Triver1/t-he/case/renders/exploded.png

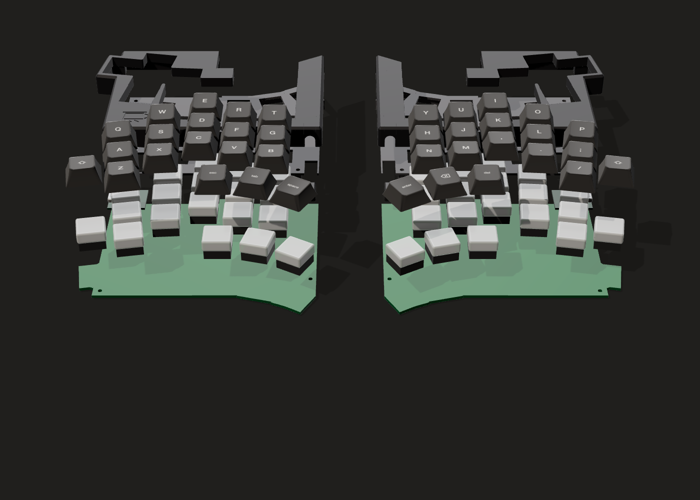
case/renders/exploded.png
