Triver1/t-he/case/renders/overview.png

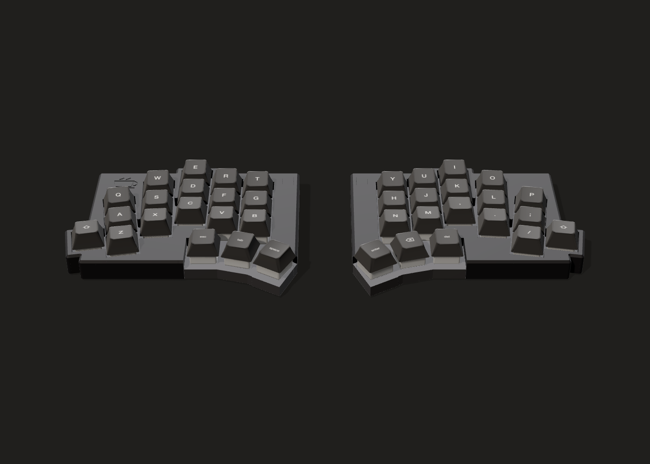
case/renders/overview.png
