Triver1/t-he/case/renders/thumb-cluster.png

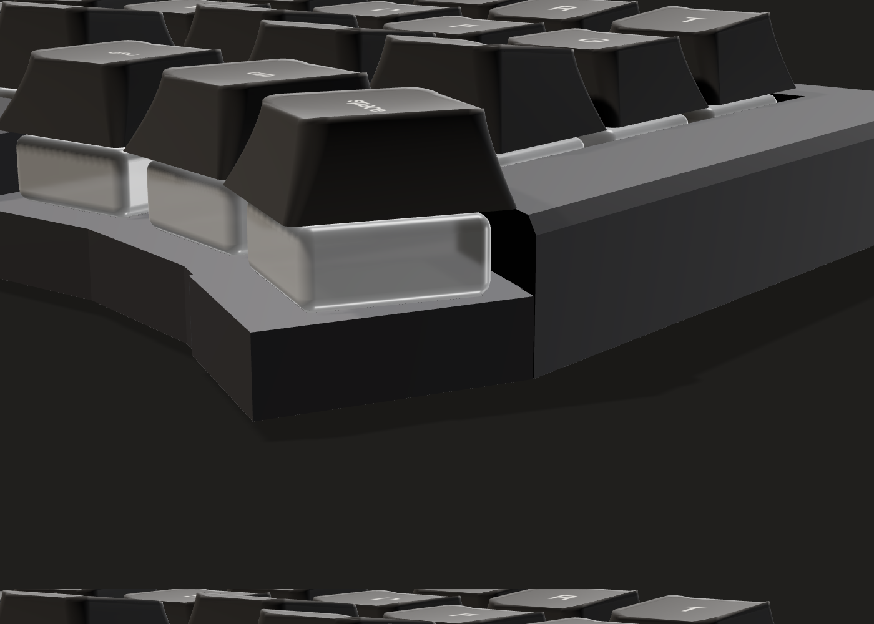
case/renders/thumb-cluster.png
