Triver1/t-he/pcb/art/cat.webp

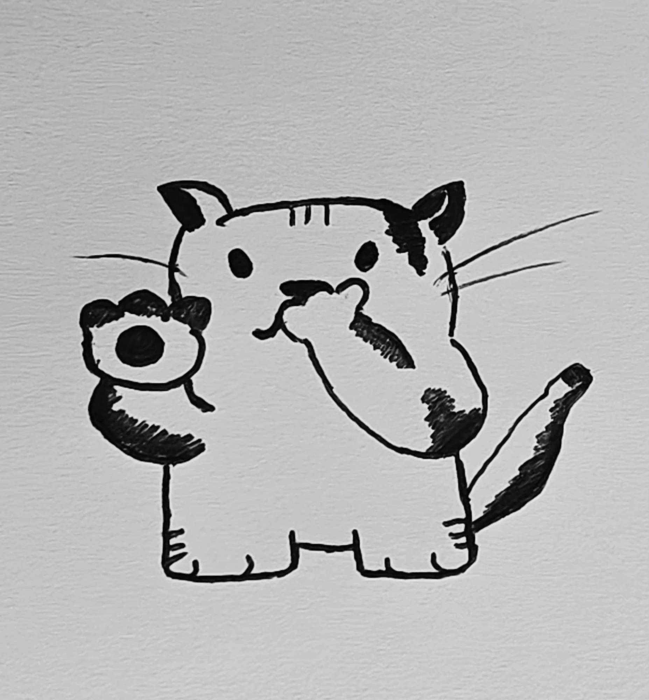
pcb/art/cat.webp
