Triver1/t-he/pcb/renders/pcb_left.png

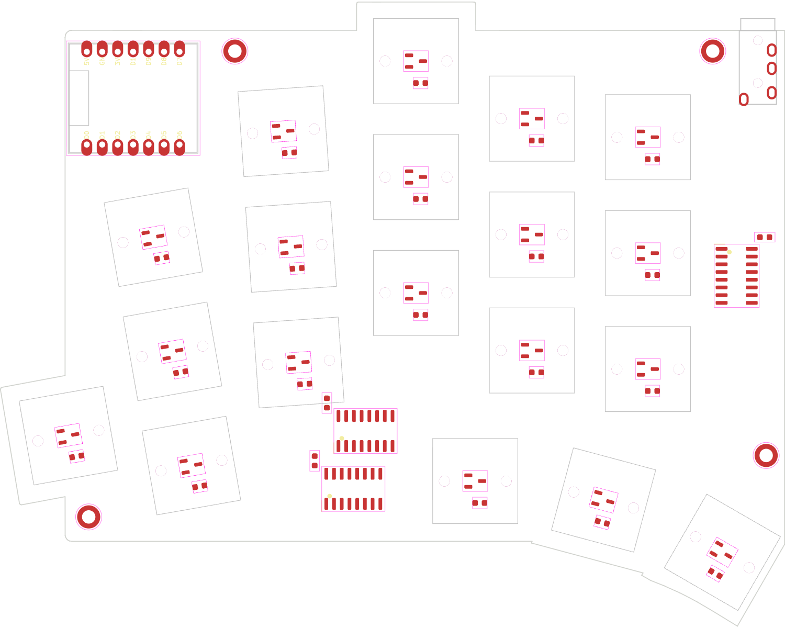
pcb/renders/pcb_left.png
