Triver1/t-he/pcb/renders/pcb_right.png

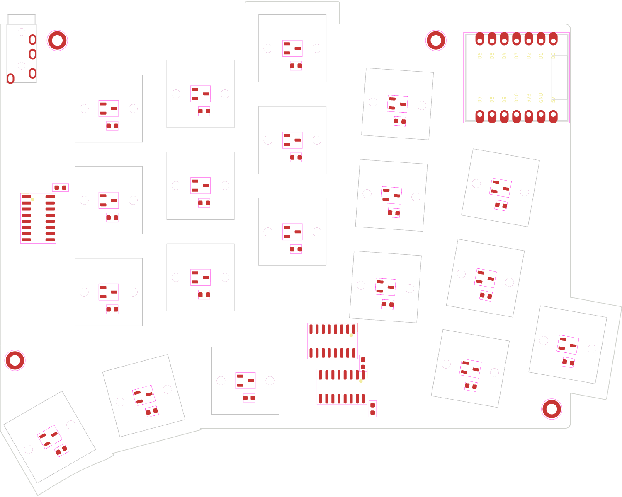
pcb/renders/pcb_right.png
