Triver1/t-he/production/lcsc_bom.csv

Quantity | LCSC Part Number | Manufacturer Part Number | Description
40 | C266128 | DRV5055A3QDBZR | Linear hall sensor, SOT-23 (38 needed, 2 spare)
6 | C9386 | 74HC4051D | 8-channel analog multiplexer, SOIC-16
50 | C1711 | CL21B104KBCNNNC | 100 nF 50 V X7R capacitor, 0805 (44 needed)
5 | C2884926 | PJ-320A | 3.5 mm TRRS jack, 4-pin through-hole (2 needed)
