Triver1/t-he/case/kicad/pcb_outline_right.dxf

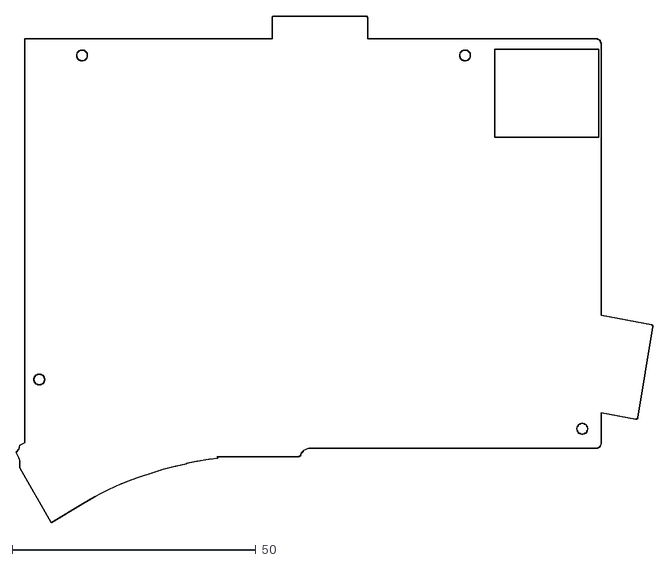
[picture p10: CAD file, 2026-09-22]
case/kicad/pcb_outline_right.dxf
130.6 x 103.9
