Triver1/t-he/case/stl/totemhe_pcbmock_left.stl

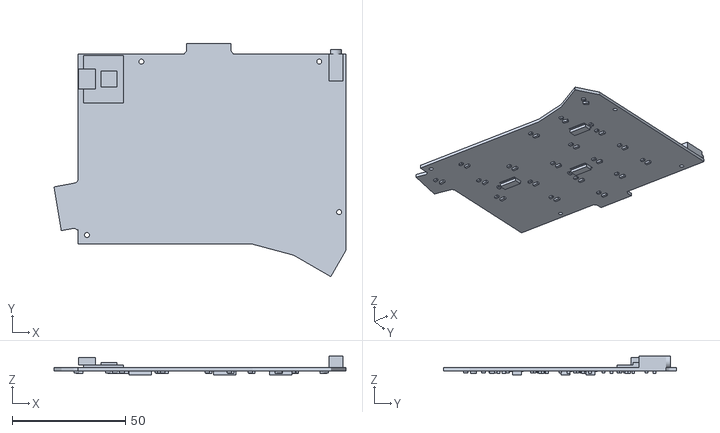
[picture p11: CAD file, 2026-10-24]
case/stl/totemhe_pcbmock_left.stl
128.9 x 103.0 x 8.25
