Triver1/t-he/pcb/out/left/outlines/board.dxf

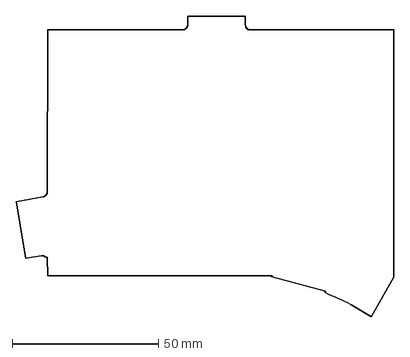
[picture p12: CAD file, 2026-09-22]
pcb/out/left/outlines/board.dxf
128.9 x 102.6 mm
