Triver1/t-he/pcb/out/left/points/demo.dxf

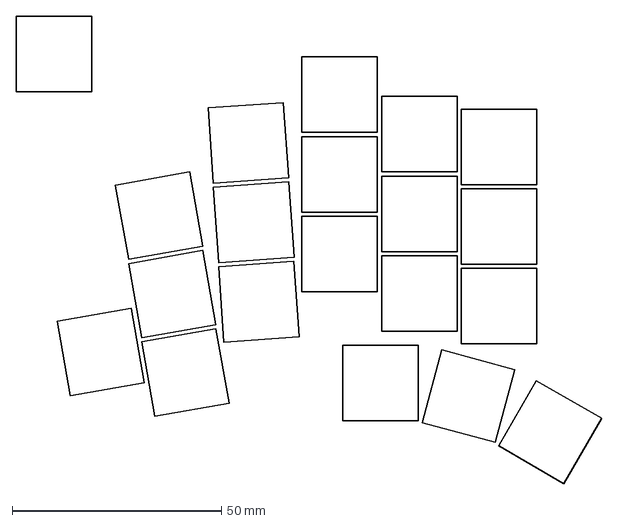
[picture p13: CAD file, 2026-09-22]
pcb/out/left/points/demo.dxf
140.0 x 111.8 mm
