Triver1/t-he/pcb/out/right/outlines/plate.dxf

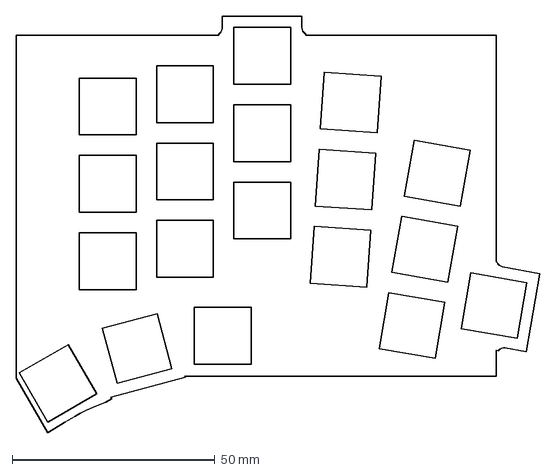
[picture p14: CAD file, 2026-09-22]
pcb/out/right/outlines/plate.dxf
128.9 x 102.6 mm
