Triver1/t-he/pcb/out/right/points/demo.dxf

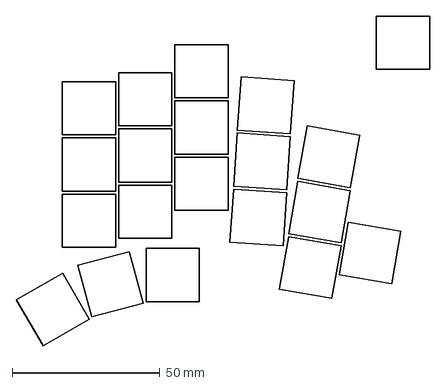
[picture p15: CAD file, 2026-09-22]
pcb/out/right/points/demo.dxf
140.0 x 111.8 mm
