Triver1/t-he/case/kicad/pcb_outline_left.dxf

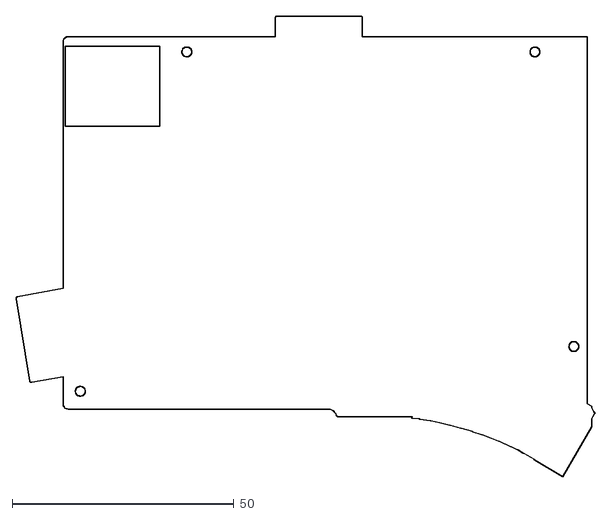
[picture p16: CAD file, 2026-09-22]
case/kicad/pcb_outline_left.dxf
130.6 x 103.9
