Triver1/t-he/pcb/out/left/outlines/plate.dxf

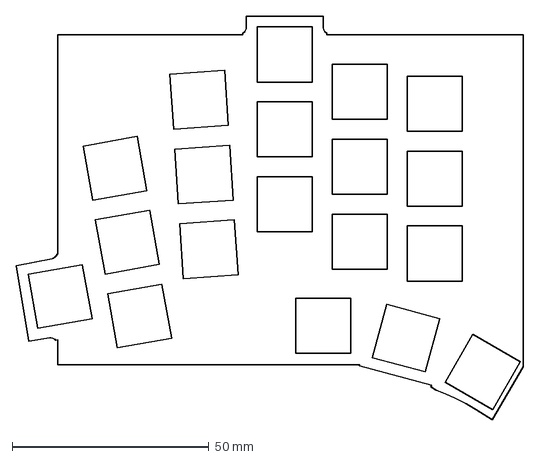
[picture p18: CAD file, 2026-09-22]
pcb/out/left/outlines/plate.dxf
128.9 x 102.6 mm
