Triver1/t-he/pcb/out/right/outlines/board.dxf

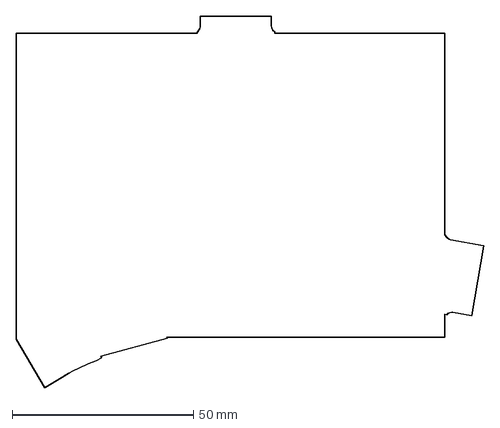
[picture p19: CAD file, 2026-09-22]
pcb/out/right/outlines/board.dxf
128.9 x 102.6 mm
