Triver1/t-he/case/stl/totemhe_foam_mold_base_right.stl

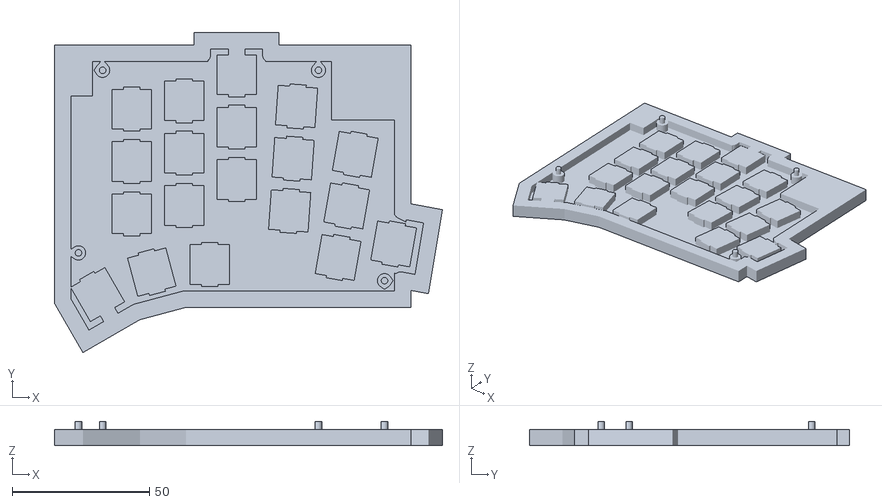
[picture p20: CAD file, 2026-10-24]
case/stl/totemhe_foam_mold_base_right.stl
141.2 x 116.5 x 8.79
