Triver1/t-he/case/stl/totemhe_plate_left.stl

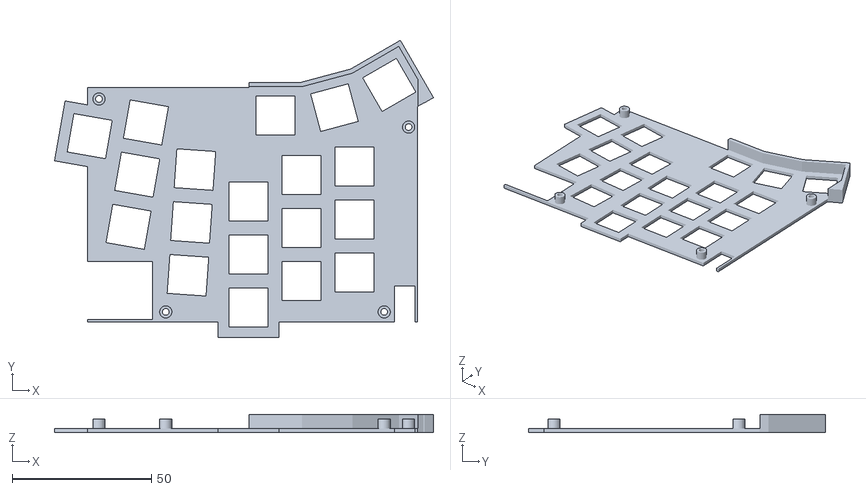
[picture p21: CAD file, 2026-10-04]
case/stl/totemhe_plate_left.stl
136.3 x 106.9 x 6.60
