Triver1/t-he/case/stl/totemhe_shell_right.stl

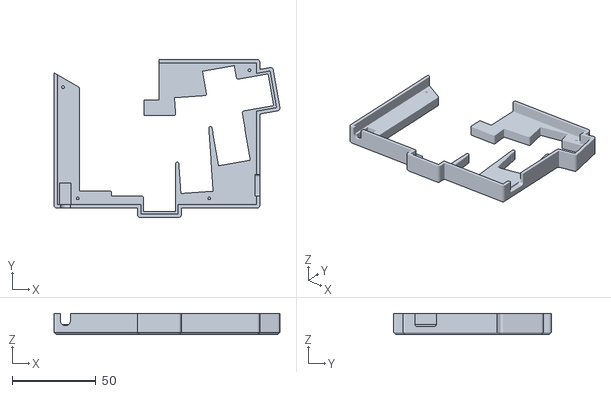
[picture p22: CAD file, 2026-10-04]
case/stl/totemhe_shell_right.stl
135.0 x 94.4 x 12.6
