Triver1/t-he/case/mock_parts.scad

// generated by gen_mock.py from totem_he.kicad_pcb: [name, x, y, rot]
mock_parts = [
  ["switch_he", 47.758, -40.236, 4.000],
  ["switch_he", 31.394, -76.180, 10.000],
  ["switch_he", 87.353, -57.268, 0.000],
  ["switch_he", 106.403, -41.266, 0.000],
  ["mux_4051", 75.300, -38.000, -90.000],
  ["switch_he", 68.303, -47.815, 0.000],
  ["switch_he", 118.878, -89.669, -30.000],
  ["mux_4051", 100.000, -70.500, 90.000],
  ["switch_he", 87.353, -19.168, 0.000],
  ["switch_he", 49.013, -59.240, 4.000],
  ["switch_he", 106.403, -22.216, 0.000],
  ["mux_4051", 38.000, -49.000, -90.000],
  ["switch_he", 106.403, -60.316, 0.000],
  ["switch_he", 11.178, -71.258, 10.000],
  ["switch_he", 25.145, -38.658, 10.000],
  ["xiao_rp2040", 21.811, -15.801, 90.000],
  ["switch_he", 99.177, -81.508, -15.000],
  ["switch_he", 68.303, -28.764, 0.000],
  ["switch_he", 46.503, -21.232, 4.000],
  ["switch_he", 28.270, -57.419, 10.000],
  ["switch_he", 78.034, -78.725, 0.000],
  ["switch_he", 87.353, -38.218, 0.000],
  ["switch_he", 68.303, -9.714, 0.000],
  ["trrs_pj320a", 124.470, -4.707, 0.000],
];
