Triver1/t-he/case/totem_geometry.scad

// TOTEM left half (GEIGEIGEIST/TOTEM rev 0.3), Choc 18 x 17 mm spacing scaled to MX 19.05 mm.
// Generated from totem_0_3.kicad_pcb and its Edge_Cuts gerber. y is up, origin at the board's top-left.
totem_pcb_edge = [[0.000,-63.652], [3.140,-82.457], [3.275,-82.602], [3.460,-82.636], [10.502,-81.320], [10.581,-81.338], [10.627,-81.431], [10.633,-87.629], [10.709,-87.946], [10.867,-88.222], [11.091,-88.439], [11.367,-88.579], [11.683,-88.630], [72.147,-88.630], [72.222,-88.663], [72.252,-88.732], [72.262,-90.062], [72.357,-90.229], [72.532,-90.312], [82.549,-90.315], [85.266,-90.356], [86.706,-90.422], [88.228,-90.536], [91.015,-90.868], [93.528,-91.296], [95.614,-91.733], [97.899,-92.283], [100.404,-92.959], [102.895,-93.701], [105.142,-94.438], [107.168,-95.173], [108.999,-95.904], [111.689,-97.117], [113.125,-97.841], [114.460,-98.564], [116.926,-100.007], [126.218,-105.684], [126.353,-105.728], [126.495,-105.702], [126.644,-105.562], [129.867,-99.651], [129.867,-85.269], [129.832,-85.186], [129.832,-74.948], [129.867,-74.864], [129.867,-20.565], [129.839,-20.490], [129.839,-5.776], [129.817,-5.547], [129.736,-5.292], [129.566,-5.024], [129.332,-4.820], [129.049,-4.693], [128.783,-4.657], [78.206,-4.656], [78.142,-4.624], [78.111,-4.545], [78.109,-0.301], [78.079,-0.186], [78.009,-0.089], [77.907,-0.021], [77.797,0.000], [58.780,-0.007], [58.612,-0.111], [58.533,-0.301], [58.532,-4.545], [58.501,-4.624], [58.437,-4.656], [11.683,-4.657], [11.472,-4.679], [11.269,-4.746], [11.008,-4.914], [10.805,-5.153], [10.673,-5.446], [10.627,-5.776], [10.625,-61.313], [10.539,-61.401], [0.245,-63.325], [0.067,-63.443]];
// [x, y, rotation, is_thumb]
totem_keys = [
  [25.145, -38.658, 10.0, 0],
  [46.503, -21.232, 4.0, 0],
  [68.303, -9.714, 0.0, 0],
  [87.353, -19.168, 0.0, 0],
  [106.403, -22.216, 0.0, 0],
  [28.270, -57.419, 10.0, 0],
  [47.758, -40.236, 4.0, 0],
  [68.303, -28.764, 0.0, 0],
  [87.353, -38.218, 0.0, 0],
  [106.403, -41.266, 0.0, 0],
  [31.394, -76.180, 10.0, 0],
  [49.013, -59.240, 4.0, 0],
  [68.303, -47.815, 0.0, 0],
  [87.353, -57.268, 0.0, 0],
  [106.403, -60.316, 0.0, 0],
  [11.178, -71.258, 10.0, 0],
  // thumbs: 4 mm further inward and 1.75 mm further up than TOTEM: the outer thumb clears the straight inner side, and thumb 1's front edge lines up with the main body's bottom edge.
  // Thumbs 2 and 3 sit on an 81.69 mm arc centred straight below thumb 1, 15 degrees apart, so the plate's front corners fall mid-gap
  [78.034, -78.725, 0.0, 1],
  [99.177, -81.508, -15.0, 1],
  [118.878, -89.669, -30.0, 1]];
totem_holes = [[125.845, -74.520], [14.509, -84.621], [38.533, -8.069], [117.061, -8.069]];
totem_xiao = [21.811, -15.801];   // centre; USB-C faces the outer edge
totem_trrs = [124.470, -4.707];   // MJ-4PP-9, mouth faces the back edge
totem_side_x = 129.870;   // the straight inner side of the board edge
