Triver1/t-he/(list of files, cad)

Other CAD files:
case/stl/totemhe_foam_mold_lid_left.stl
case/stl/totemhe_pcbmock_right.stl
case/stl/totemhe_foam_mold_base_left.stl
case/stl/totemhe_shell_left.stl
case/stl/totemhe_plate_right.stl
case/mock_parts_right.scad
