Triver1/t-he/pcb/totem_he.kicad_pcb

## KiCad design pcb/totem_he.kicad_pcb (2026-10-24)

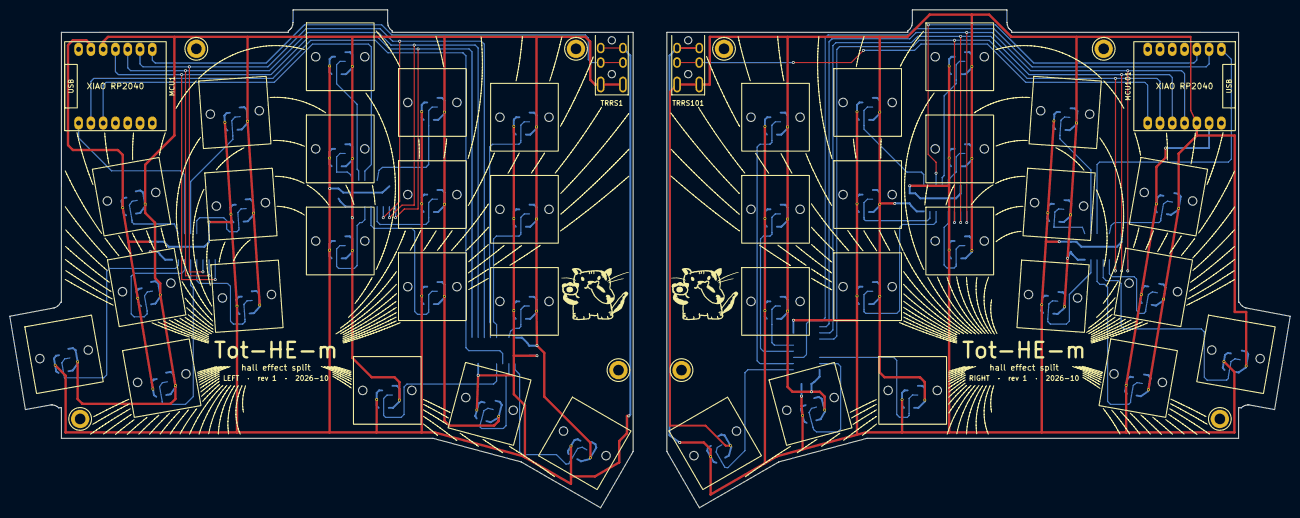
[picture p23: board totem_he.kicad_pcb from above]

Board: 2 copper layers, 264.8 x 103.0 mm, 56 parts (0 on the bottom side), 56 nets.

Parts:
H1, H2, H3, H4, H101, H102, H103, H104: mounting_hole_plated
IC1, IC2, IC3, IC101, IC102, IC103: mux_4051
MCU1, MCU101: xiao_rp2040
S1, S2, S3, S4, S5, S6, S7, S8, S9, S10, S11, S12, S13, S14, S15, S16, S17, S18, S19, S101, S102, S103, S104, S105, S106, S107, S108, S109, S110, S111, S112, S113, S114, S115, S116, S117, S118, S119: switch_he
TRRS1, TRRS101: trrs_pj320a

Connections:
L/ADC_A: IC1.3, MCU1.1
L/ADC_B: IC2.3, MCU1.3
L/ADC_C: IC3.3, MCU1.2
L/DATA: MCU1.8, TRRS1.3
L/GND: IC1.6, IC1.7, IC1.8, IC1.C2, IC2.6, IC2.7, IC2.8, IC2.C2, IC3.6, IC3.7, IC3.8, IC3.C2, MCU1.13, S1.3, S1.C2, S2.3, S2.C2, S3.3, S3.C2, S4.3, S4.C2, S5.3, S5.C2, S6.3, S6.C2, S7.3, S7.C2, S8.3, S8.C2, S9.3, S9.C2, S10.3, S10.C2, S11.3, S11.C2, S12.3, S12.C2, S13.3, S13.C2, S14.3, S14.C2, S15.3, S15.C2, S16.3, S16.C2, S17.3, S17.C2, S18.3, S18.C2, S19.3, S19.C2, TRRS1.2
L/K_INDEX_BOTTOM: IC2.13, S14.2
L/K_INDEX_HOME: IC2.12, S9.2
L/K_INDEX_TOP: IC2.5, S4.2
L/K_INNER_BOTTOM: IC3.15, S15.2
L/K_INNER_HOME: IC3.13, S10.2
L/K_INNER_TOP: IC3.12, S5.2
L/K_MIDDLE_BOTTOM: IC2.14, S13.2
L/K_MIDDLE_HOME: IC2.1, S8.2
L/K_MIDDLE_TOP: IC2.2, S3.2
L/K_OUTER: IC1.15, S16.2
L/K_PINKY_BOTTOM: IC1.13, S11.2
L/K_PINKY_HOME: IC1.14, S6.2
L/K_PINKY_TOP: IC1.2, S1.2
L/K_RING_BOTTOM: IC1.12, S12.2
L/K_RING_HOME: IC1.5, S7.2
L/K_RING_TOP: IC1.4, S2.2
L/K_THUMB1: IC3.4, S17.2
L/K_THUMB2: IC3.2, S18.2
L/K_THUMB3: IC3.1, S19.2
L/SEL0: IC1.11, IC2.11, IC3.11, MCU1.9
L/SEL1: IC1.10, IC2.10, IC3.10, MCU1.10
L/SEL2: IC1.9, IC2.9, IC3.9, MCU1.11
L/VCC: IC1.16, IC1.C1, IC2.16, IC2.C1, IC3.16, IC3.C1, MCU1.12, S1.1, S1.C1, S2.1, S2.C1, S3.1, S3.C1, S4.1, S4.C1, S5.1, S5.C1, S6.1, S6.C1, S7.1, S7.C1, S8.1, S8.C1, S9.1, S9.C1, S10.1, S10.C1, S11.1, S11.C1, S12.1, S12.C1, S13.1, S13.C1, S14.1, S14.C1, S15.1, S15.C1, S16.1, S16.C1, S17.1, S17.C1, S18.1, S18.C1, S19.1, S19.C1, TRRS1.4
R/ADC_A: IC101.3, MCU101.1
R/ADC_B: IC102.3, MCU101.3
R/ADC_C: IC103.3, MCU101.2
R/DATA: MCU101.8, TRRS101.3
R/GND: IC101.6, IC101.7, IC101.8, IC101.C2, IC102.6, IC102.7, IC102.8, IC102.C2, IC103.6, IC103.7, IC103.8, IC103.C2, MCU101.13, S101.3, S101.C2, S102.3, S102.C2, S103.3, S103.C2, S104.3, S104.C2, S105.3, S105.C2, S106.3, S106.C2, S107.3, S107.C2, S108.3, S108.C2, S109.3, S109.C2, S110.3, S110.C2, S111.3, S111.C2, S112.3, S112.C2, S113.3, S113.C2, S114.3, S114.C2, S115.3, S115.C2, S116.3, S116.C2, S117.3, S117.C2, S118.3, S118.C2, S119.3, S119.C2, TRRS101.2
R/K_INDEX_BOTTOM: IC102.14, S114.2
R/K_INDEX_HOME: IC102.15, S109.2
R/K_INDEX_TOP: IC102.1, S104.2
R/K_INNER_BOTTOM: IC103.5, S115.2
R/K_INNER_HOME: IC103.4, S110.2
R/K_INNER_TOP: IC103.2, S105.2
R/K_MIDDLE_BOTTOM: IC102.12, S113.2
R/K_MIDDLE_HOME: IC102.5, S108.2
R/K_MIDDLE_TOP: IC102.4, S103.2
R/K_OUTER: IC101.13, S116.2
R/K_PINKY_BOTTOM: IC101.14, S111.2
R/K_PINKY_HOME: IC101.12, S106.2
R/K_PINKY_TOP: IC101.5, S101.2
R/K_RING_BOTTOM: IC101.15, S112.2
R/K_RING_HOME: IC101.1, S107.2
R/K_RING_TOP: IC101.2, S102.2
R/K_THUMB1: IC103.14, S117.2
R/K_THUMB2: IC103.15, S118.2
R/K_THUMB3: IC103.1, S119.2
R/SEL0: IC101.11, IC102.11, IC103.11, MCU101.9
R/SEL1: IC101.10, IC102.10, IC103.10, MCU101.10
R/SEL2: IC101.9, IC102.9, IC103.9, MCU101.11
R/VCC: IC101.16, IC101.C1, IC102.16, IC102.C1, IC103.16, IC103.C1, MCU101.12, S101.1, S101.C1, S102.1, S102.C1, S103.1, S103.C1, S104.1, S104.C1, S105.1, S105.C1, S106.1, S106.C1, S107.1, S107.C1, S108.1, S108.C1, S109.1, S109.C1, S110.1, S110.C1, S111.1, S111.C1, S112.1, S112.C1, S113.1, S113.C1, S114.1, S114.C1, S115.1, S115.C1, S116.1, S116.C1, S117.1, S117.C1, S118.1, S118.C1, S119.1, S119.C1, TRRS101.4
