Triver1/t-he/pcb/out/left/pcbs/totem_he_left.kicad_pcb

## KiCad design pcb/out/left/pcbs/totem_he_left.kicad_pcb (2026-09-22)

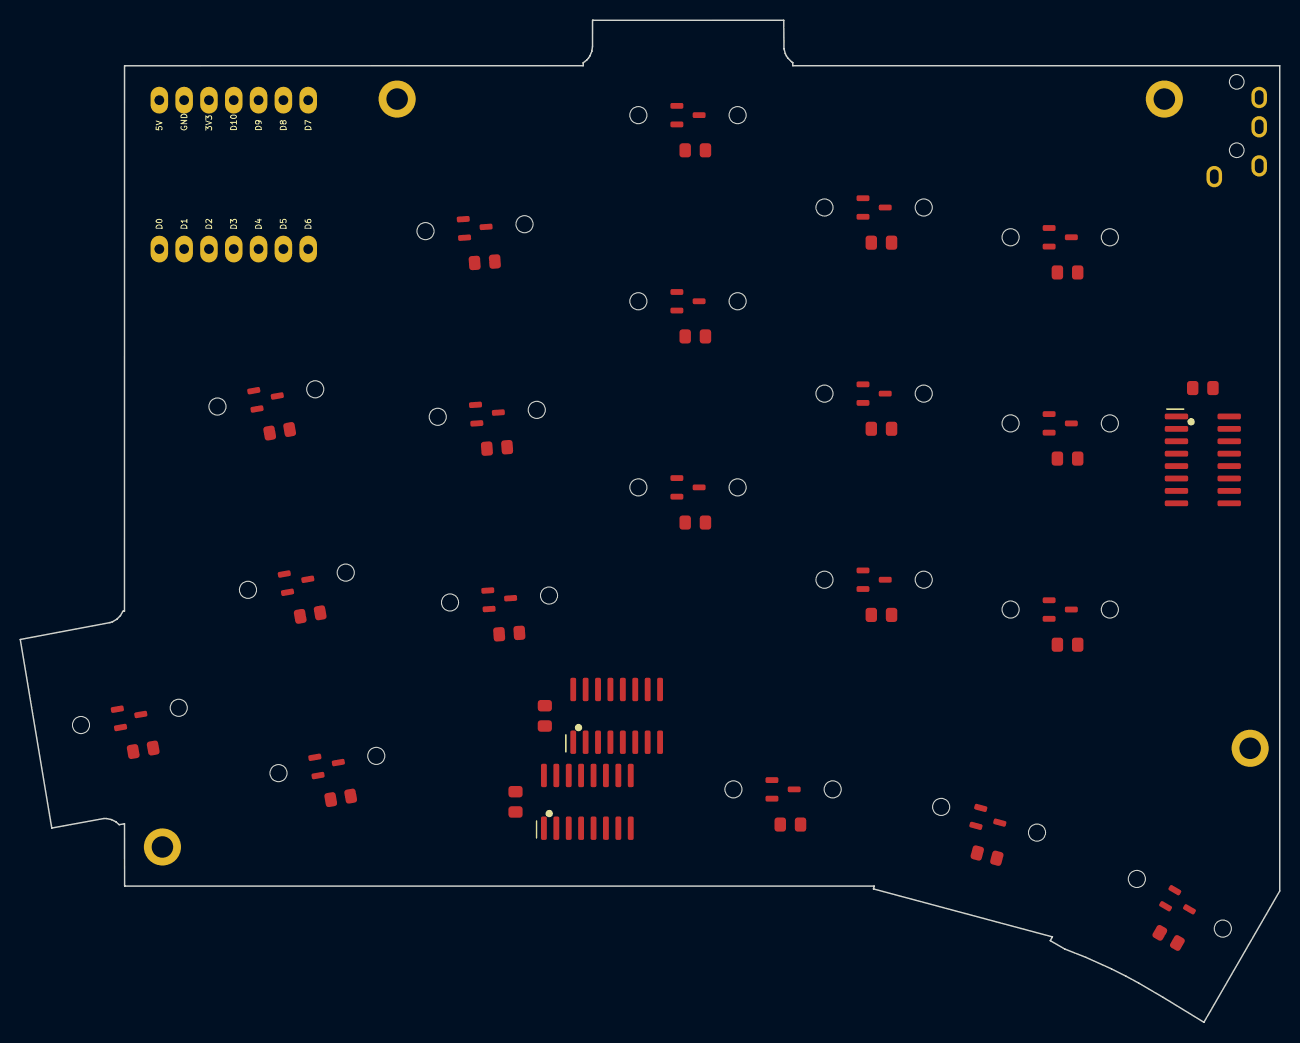
[picture p24: board totem_he_left.kicad_pcb from above]

Board: 2 copper layers, 128.9 x 102.6 mm, 28 parts (0 on the bottom side), 30 nets, no tracks yet.

Parts:
H1, H2, H3, H4: mounting_hole_plated
IC1, IC2, IC3: mux_4051
MCU1: xiao_rp2040
S1, S2, S3, S4, S5, S6, S7, S8, S9, S10, S11, S12, S13, S14, S15, S16, S17, S18, S19: switch_he
TRRS1: trrs_pj320a

Connections:
ADC_A: IC1.3, MCU1.1
ADC_B: IC2.3, MCU1.2
ADC_C: IC3.3, MCU1.3
GND: IC1.6, IC1.7, IC1.8, IC1.C2, IC2.6, IC2.7, IC2.8, IC2.C2, IC3.6, IC3.7, IC3.8, IC3.C2, MCU1.13, S1.2, S1.C2, S2.2, S2.C2, S3.2, S3.C2, S4.2, S4.C2, S5.2, S5.C2, S6.2, S6.C2, S7.2, S7.C2, S8.2, S8.C2, S9.2, S9.C2, S10.2, S10.C2, S11.2, S11.C2, S12.2, S12.C2, S13.2, S13.C2, S14.2, S14.C2, S15.2, S15.C2, S16.2, S16.C2, S17.2, S17.C2, S18.2, S18.C2, S19.2, S19.C2, TRRS1.2
K_INDEX_BOTTOM: IC2.12, S10.3
K_INDEX_HOME: IC2.1, S11.3
K_INDEX_TOP: IC2.5, S12.3
K_INNER_BOTTOM: IC3.13, S13.3
K_INNER_HOME: IC3.14, S14.3
K_INNER_TOP: IC3.15, S15.3
K_MIDDLE_BOTTOM: IC2.13, S7.3
K_MIDDLE_HOME: IC2.14, S8.3
K_MIDDLE_TOP: IC2.15, S9.3
K_OUTER: IC1.12, S16.3
K_PINKY_BOTTOM: IC1.13, S1.3
K_PINKY_HOME: IC1.14, S2.3
K_PINKY_TOP: IC1.15, S3.3
K_RING_BOTTOM: IC1.1, S4.3
K_RING_HOME: IC1.5, S5.3
K_RING_TOP: IC1.2, S6.3
K_THUMB1: IC2.2, S17.3
K_THUMB2: IC2.4, S18.3
K_THUMB3: IC3.12, S19.3
RX: MCU1.8, TRRS1.3
SEL0: IC1.11, IC2.11, IC3.11, MCU1.5
SEL1: IC1.10, IC2.10, IC3.10, MCU1.6
SEL2: IC1.9, IC2.9, IC3.9, MCU1.9
TX: MCU1.7, TRRS1.5
VCC: IC1.16, IC1.C1, IC2.16, IC2.C1, IC3.16, IC3.C1, MCU1.12, S1.1, S1.C1, S2.1, S2.C1, S3.1, S3.C1, S4.1, S4.C1, S5.1, S5.C1, S6.1, S6.C1, S7.1, S7.C1, S8.1, S8.C1, S9.1, S9.C1, S10.1, S10.C1, S11.1, S11.C1, S12.1, S12.C1, S13.1, S13.C1, S14.1, S14.C1, S15.1, S15.C1, S16.1, S16.C1, S17.1, S17.C1, S18.1, S18.C1, S19.1, S19.C1, TRRS1.4
Y7: IC1.4, IC3.4
