Triver1/t-he/pcb/out/left/config.yaml

meta:
  engine: 4.1.0
  name: totem_he_left
units:
  u: 19.05
points:
  zones:
    origin:
      anchor: {shift: [0, 0]}
      columns: {o: }
      rows: {r: {tags: [helper]}}
    pinky:
      anchor: {shift: [31.394, -76.180], rotate: 10.000}
      key: {padding: u, tags: [alpha]}
      columns: {c: }
      rows:
        bottom: {name: pinky_bottom, out_net: K_PINKY_BOTTOM}
        home: {name: pinky_home, out_net: K_PINKY_HOME, adjust: {shift: [0.181, -0.032]}}
        top: {name: pinky_top, out_net: K_PINKY_TOP, adjust: {shift: [0.362, -0.063]}}
    ring:
      anchor: {shift: [49.013, -59.240], rotate: 4.000}
      key: {padding: u, tags: [alpha]}
      columns: {c: }
      rows:
        bottom: {name: ring_bottom, out_net: K_RING_BOTTOM}
        home: {name: ring_home, out_net: K_RING_HOME, adjust: {shift: [0.074, -0.005]}}
        top: {name: ring_top, out_net: K_RING_TOP, adjust: {shift: [0.147, -0.009]}}
    middle:
      anchor: {shift: [68.303, -47.815], rotate: 0.000}
      key: {padding: u, tags: [alpha]}
      columns: {c: }
      rows:
        bottom: {name: middle_bottom, out_net: K_MIDDLE_BOTTOM}
        home: {name: middle_home, out_net: K_MIDDLE_HOME, adjust: {shift: [0.000, 0.001]}}
        top: {name: middle_top, out_net: K_MIDDLE_TOP, adjust: {shift: [0.000, 0.001]}}
    index:
      anchor: {shift: [87.353, -57.268], rotate: 0.000}
      key: {padding: u, tags: [alpha]}
      columns: {c: }
      rows:
        bottom: {name: index_bottom, out_net: K_INDEX_BOTTOM}
        home: {name: index_home, out_net: K_INDEX_HOME}
        top: {name: index_top, out_net: K_INDEX_TOP}
    inner:
      anchor: {shift: [106.403, -60.316], rotate: 0.000}
      key: {padding: u, tags: [alpha]}
      columns: {c: }
      rows:
        bottom: {name: inner_bottom, out_net: K_INNER_BOTTOM}
        home: {name: inner_home, out_net: K_INNER_HOME}
        top: {name: inner_top, out_net: K_INNER_TOP}
    outer:
      anchor: {shift: [11.178, -71.258], rotate: 10.000}
      key: {padding: u, tags: [alpha]}
      columns: {c: }
      rows:
        k: {name: outer, out_net: K_OUTER}
    thumb1:
      anchor: {shift: [78.034, -78.725], rotate: 0.000}
      key: {padding: u, tags: [thumb]}
      columns: {c: }
      rows:
        k: {name: thumb1, out_net: K_THUMB1}
    thumb2:
      anchor: {shift: [99.120, -81.835], rotate: -15.000}
      key: {padding: u, tags: [thumb]}
      columns: {c: }
      rows:
        k: {name: thumb2, out_net: K_THUMB2}
    thumb3:
      anchor: {shift: [118.647, -90.435], rotate: -30.000}
      key: {padding: u, tags: [thumb]}
      columns: {c: }
      rows:
        k: {name: thumb3, out_net: K_THUMB3}
outlines:
  board:
    - what: polygon
      operation: add
      points:
        - {ref: origin_o_r, shift: [78.892, -4.243]}
        - {ref: origin_o_r, shift: [78.523, -3.874]}
        - {ref: origin_o_r, shift: [78.378, -3.656]}
        - {ref: origin_o_r, shift: [78.262, -3.421]}
        - {ref: origin_o_r, shift: [78.127, -2.917]}
        - {ref: origin_o_r, shift: [78.105, -0.004]}
        - {ref: origin_o_r, shift: [58.599, -0.007]}
        - {ref: origin_o_r, shift: [58.537, -0.011]}
        - {ref: origin_o_r, shift: [58.533, -0.072]}
        - {ref: origin_o_r, shift: [58.532, -2.657]}
        - {ref: origin_o_r, shift: [58.464, -3.174]}
        - {ref: origin_o_r, shift: [58.264, -3.656]}
        - {ref: origin_o_r, shift: [58.119, -3.874]}
        - {ref: origin_o_r, shift: [57.946, -4.071]}
        - {ref: origin_o_r, shift: [57.578, -4.358]}
        - {ref: origin_o_r, shift: [57.578, -4.656]}
        - {ref: origin_o_r, shift: [10.631, -4.661]}
        - {ref: origin_o_r, shift: [10.625, -60.465]}
        - {ref: origin_o_r, shift: [10.472, -60.492]}
        - {ref: origin_o_r, shift: [10.212, -60.942]}
        - {ref: origin_o_r, shift: [9.843, -61.311]}
        - {ref: origin_o_r, shift: [9.390, -61.572]}
        - {ref: origin_o_r, shift: [9.143, -61.656]}
        - {ref: origin_o_r, shift: [-0.041, -63.383]}
        - {ref: origin_o_r, shift: [3.182, -82.683]}
        - {ref: origin_o_r, shift: [8.522, -81.707]}
        - {ref: origin_o_r, shift: [8.783, -81.710]}
        - {ref: origin_o_r, shift: [9.294, -81.818]}
        - {ref: origin_o_r, shift: [9.760, -82.055]}
        - {ref: origin_o_r, shift: [10.087, -82.341]}
        - {ref: origin_o_r, shift: [10.628, -82.245]}
        - {ref: origin_o_r, shift: [10.638, -88.626]}
        - {ref: origin_o_r, shift: [87.362, -88.625]}
        - {ref: origin_o_r, shift: [87.285, -88.913]}
        - {ref: origin_o_r, shift: [105.606, -93.822]}
        - {ref: origin_o_r, shift: [105.383, -94.209]}
        - {ref: origin_o_r, shift: [106.860, -95.061]}
        - {ref: origin_o_r, shift: [109.039, -95.922]}
        - {ref: origin_o_r, shift: [111.649, -97.099]}
        - {ref: origin_o_r, shift: [113.151, -97.855]}
        - {ref: origin_o_r, shift: [114.431, -98.548]}
        - {ref: origin_o_r, shift: [116.943, -100.017]}
        - {ref: origin_o_r, shift: [121.112, -102.565]}
        - {ref: origin_o_r, shift: [128.870, -89.128]}
        - {ref: origin_o_r, shift: [128.870, -4.657]}
        - {ref: origin_o_r, shift: [79.028, -4.656]}
        - {ref: origin_o_r, shift: [79.028, -4.333]}
  plate:
    - what: outline
      name: board
    - what: rectangle
      operation: subtract
      where: [alpha, thumb]
      size: 14
pcbs:
  totem_he_left:
    template: kicad8
    outlines:
      main: {outline: board}
    footprints:
      - what: switch_he
        where: [alpha, thumb]
        params: {VCC: VCC, GND: GND, OUT: "{{out_net}}"}
      - what: mux_4051
        where: {ref: origin_o_r, shift: [58.000, -80.000], rotate: 90.000}
        params: {VCC: VCC, GND: GND, Z: ADC_A, S0: SEL0, S1: SEL1, S2: SEL2, Y0: K_PINKY_BOTTOM, Y1: K_PINKY_HOME, Y2: K_PINKY_TOP, Y3: K_OUTER, Y4: K_RING_BOTTOM, Y5: K_RING_HOME, Y6: K_RING_TOP}
      - what: mux_4051
        where: {ref: origin_o_r, shift: [61.000, -71.200], rotate: 90.000}
        params: {VCC: VCC, GND: GND, Z: ADC_B, S0: SEL0, S1: SEL1, S2: SEL2, Y0: K_MIDDLE_BOTTOM, Y1: K_MIDDLE_HOME, Y2: K_MIDDLE_TOP, Y3: K_INDEX_BOTTOM, Y4: K_INDEX_HOME, Y5: K_INDEX_TOP, Y6: K_THUMB1, Y7: K_THUMB2}
      - what: mux_4051
        where: {ref: origin_o_r, shift: [121.000, -45.000], rotate: 0.000}
        params: {VCC: VCC, GND: GND, Z: ADC_C, S0: SEL0, S1: SEL1, S2: SEL2, Y0: K_INNER_BOTTOM, Y1: K_INNER_HOME, Y2: K_INNER_TOP, Y3: K_THUMB3}
      - what: xiao_rp2040
        where: {ref: origin_o_r, shift: [21.811, -15.801], rotate: 90.000}
        params: {D0: ADC_A, D1: ADC_B, D2: ADC_C, D4: SEL0, D5: SEL1, D8: SEL2, D6: TX, D7: RX, V3: VCC, GND: GND}
      - what: ceoloide/trrs_pj320a
        where: {ref: origin_o_r, shift: [124.470, -4.707]}
        params: {TP: VCC, R1: TX, R2: RX, SL: GND}
      - what: ceoloide/mounting_hole_plated
        where: {ref: origin_o_r, shift: [125.845, -74.520]}
        params: {drill: 2.2}
      - what: ceoloide/mounting_hole_plated
        where: {ref: origin_o_r, shift: [14.509, -84.621]}
        params: {drill: 2.2}
      - what: ceoloide/mounting_hole_plated
        where: {ref: origin_o_r, shift: [38.533, -8.069]}
        params: {drill: 2.2}
      - what: ceoloide/mounting_hole_plated
        where: {ref: origin_o_r, shift: [117.061, -8.069]}
        params: {drill: 2.2}
