Triver1/t-he/firmware/qmk/tot_he_m/he_map.h

// SPDX-License-Identifier: GPL-2.0-or-later
// Pin and channel map of the routed board (pcb/totem_he.kicad_pcb): which XIAO pins drive the muxes, and which mux
// channel carries which key on each half.
#pragma once

// mux commons, one per matrix row: D0 (mux IC1), D1 (mux IC3), D2 (mux IC2)
#define HE_ROW_PINS { GP26, GP27, GP28 }
// shared select lines S0 (LSB), S1, S2: D8, D9, D10
#define HE_SEL_PINS { GP2, GP4, GP3 }

// channels with a sensor on them, one bit per mux channel
#define HE_PRESENT_LEFT  { 0xEF, 0xDD, 0x7B }
#define HE_PRESENT_RIGHT { 0x7F, 0xF6, 0xBE }

// key names, printed by the self test
#define HE_NAMES_LEFT { \
    {"pinky_bottom", "pinky_home", "outer", "ring_bottom", NULL, "ring_home", "pinky_top", "ring_top"}, \
    {"inner_home", NULL, "inner_bottom", "inner_top", "thumb3", NULL, "thumb2", "thumb1"}, \
    {"index_bottom", "middle_bottom", NULL, "index_home", "middle_home", "index_top", "middle_top", NULL} \
}
#define HE_NAMES_RIGHT { \
    {"outer", "pinky_bottom", "ring_bottom", "pinky_home", "ring_home", "pinky_top", "ring_top", NULL}, \
    {NULL, "thumb1", "thumb2", NULL, "thumb3", "inner_bottom", "inner_top", "inner_home"}, \
    {NULL, "index_bottom", "index_home", "middle_bottom", "index_top", "middle_home", NULL, "middle_top"} \
}


// split link: one half-duplex wire on TRRS ring 2, D7
#define SERIAL_USART_TX_PIN GP1
