Triver1/t-he/(commit log)

2026-10-04 Both halves in one KiCad file, sensors under the board, generated firmware
    Replaces the Ergogen pipeline with KiCad Python scripts. The PCB file holds
    the left half and its mirror; sensors, capacitors and muxes sit on the
    underside, one mux per finger group, with vias for the select lines. QMK
    firmware tables come from the board (firmware/gen_firmware.py), checked by
    pcb/netcheck.py. Adds the 3D case viewer and prebuilt UF2 files.
2026-10-24 Tot-HE-m: routed board, Ergogen modules, final firmware, foam mold
    Board
    - Ergogen footprint modules for the switch/sensor, mux, XIAO, TRRS and holes; build.sh regenerates the board
    from the case geometry and mux_map.json
    - Hand routing from routes.py with the route.py tool: signals on the underside, power as two combs on top
    - Silkscreen outlines and labels, board text, field-line artwork and the cat (art.py, art/)
    - panel.py and gerbers.sh: both halves joined by snap-off tabs, Gerbers and drill files for JLCPCB
    Firmware
    - Pin and channel maps regenerated from the routed board; USB name Tot-HE-m; UF2s rebuilt
    Case
    - PCB mock updated to the final part positions
    - foam_mold.scad: two-part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
2026-10-24 Firmware: calibration fix, typed self test, glitch filtering, left/right builds
    - Keys no longer assume 150 counts of travel: they fire at HE_MIN_ACTUATION and learn their travel from
    confirmed presses; the rest reading follows slow drift
    - Readings: 10 us mux settle, 4 averaged conversions
    - A scan where most keys jump at once is dropped, and a key changes state only after HE_DEBOUNCE_SCANS
    agreeing scans (all channels dip together about every 1.4 s on the first assembled half; cause not found yet)
    - typediag keymap types the self test into a text editor, for testing without the QMK CLI
    - build.sh also builds the_he_left.uf2 / the_he_right.uf2 with the side built in; the_he_first.uf2 ke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
2026-10-25 Firmware: VIA, depth in mm, rapid trigger, bottom-out learning, controller layer, Sweep keymap
    - VIA support (via, via_left, via_right builds) with a Hall effect menu; definition generated into
    firmware/via/tot-he-m.json. USB vendor id 0x746D, since VIA refuses QMK's placeholder 0xFEED.
    - Actuation and release set as key depth in 0.1 mm: readings are mapped to depth with an inverse-cube
    field model (depth_lut); noise floor lowered to 15 counts, glitch filter keeps its own 40.
    - Rapid trigger with press and release sensitivity.
    - Settings stored in the keyboard's EEPROM block and sent from the USB half to the other half.
    - Bottom-out learning while typing: travel follows consistent bottom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
2026-10-25 Clean up: rename firmware to tot_he_m, refresh READMEs
    - QMK keyboard folder, header and build outputs renamed from the_he to tot_he_m.
    - README: routed PCB, firmware summary, TRRS (not TRS) cable warning, assembly checks from the first build.
    - pcb/README: both order scripts documented (gerbers.sh panel, production.sh), stale DRC note removed.
2026-10-25 Firmware: drop combos, flash halves over USB with flash.py
    - Keymap without the Sweep combos.
    - VIA's id_bootloader_jump restarts a half into its UF2 bootloader, and a read-only value
    reports its side, so firmware/flash.py can update both halves without the BOOT button.
2026-10-25 flash.py: --reset-keymap loads the compiled keymap into VIA after flashing
    VIA keeps its stored keymap across flashes, so the Sweep layout never reached the board.
2026-10-26 Clean up the repository
    Keep the KiCad project with its Ergogen config, the case sources and STLs, and the firmware; drop the
    generator, routing, checking and helper scripts, the PCB mock, the HTML viewer and the diagnostic
    firmware builds. Add ready order files (JLCPCB Gerbers, LCSC BOM), PCB and case renders, and a README
    that explains the project, its cost, ordering, building and VIA.
